Danion1/robot-arm-moveit2/cad_export/antebraco/chapa.step

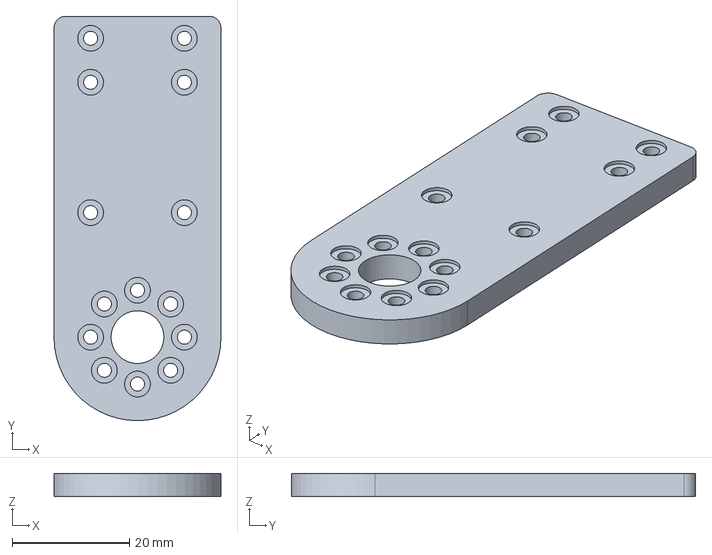
[picture p4: CAD file, 2026-10-29]
cad_export/antebraco/chapa.step
28.5 x 69.0 x 4.00 mm
