Danion1/robot-arm-moveit2/cad_export/base/base.step

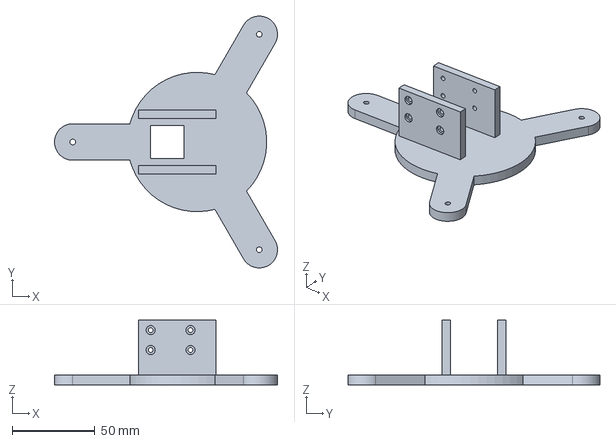
[picture p5: CAD file, 2026-10-29]
cad_export/base/base.step
134.5 x 151.9 x 39.0 mm
