Danion1/robot-arm-moveit2/cad_export/braco/chapa.step

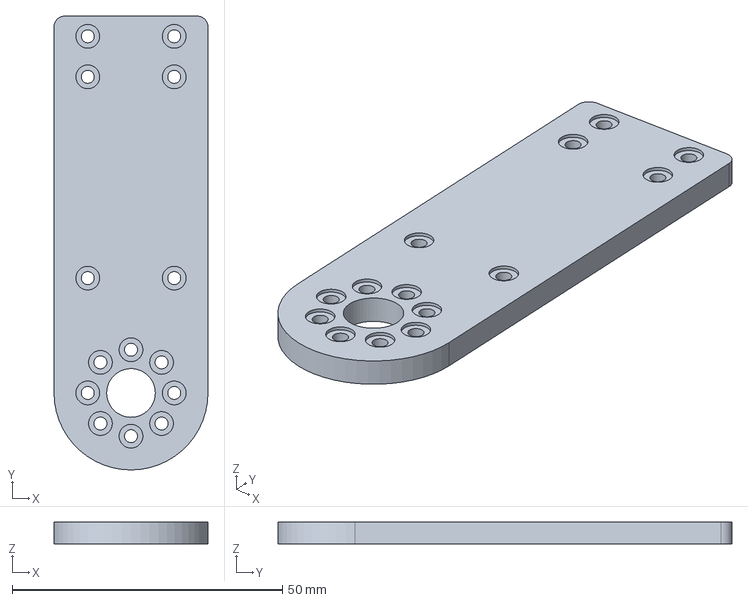
[picture p6: CAD file, 2026-10-29]
cad_export/braco/chapa.step
28.5 x 84.0 x 4.00 mm
