Danion1/robot-arm-moveit2/cad_export/garra/guia_baixo.step

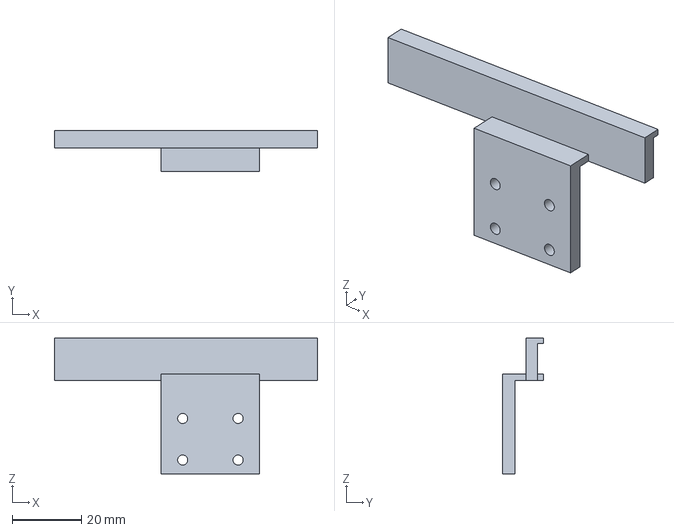
[picture p7: CAD file, 2026-10-29]
cad_export/garra/guia_baixo.step
75.9 x 11.8 x 39.2 mm
