Danion1/robot-arm-moveit2/cad_export/junta/ponte.step

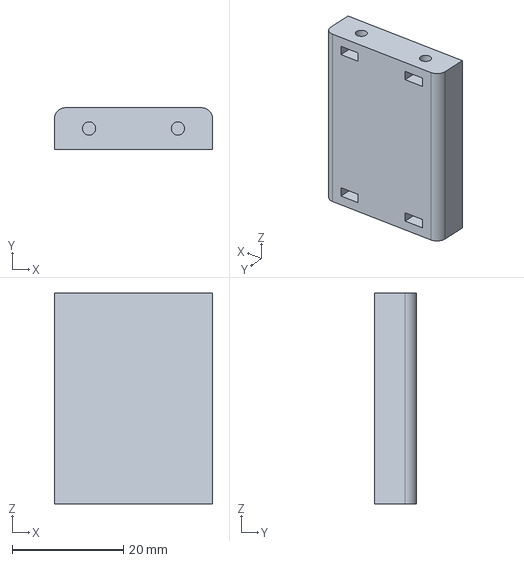
[picture p8: CAD file, 2026-10-29]
cad_export/junta/ponte.step
28.5 x 7.50 x 38.0 mm
