Danion1/robot-arm-moveit2/ros2/braco2_description/meshes/mordente_baixo.stl

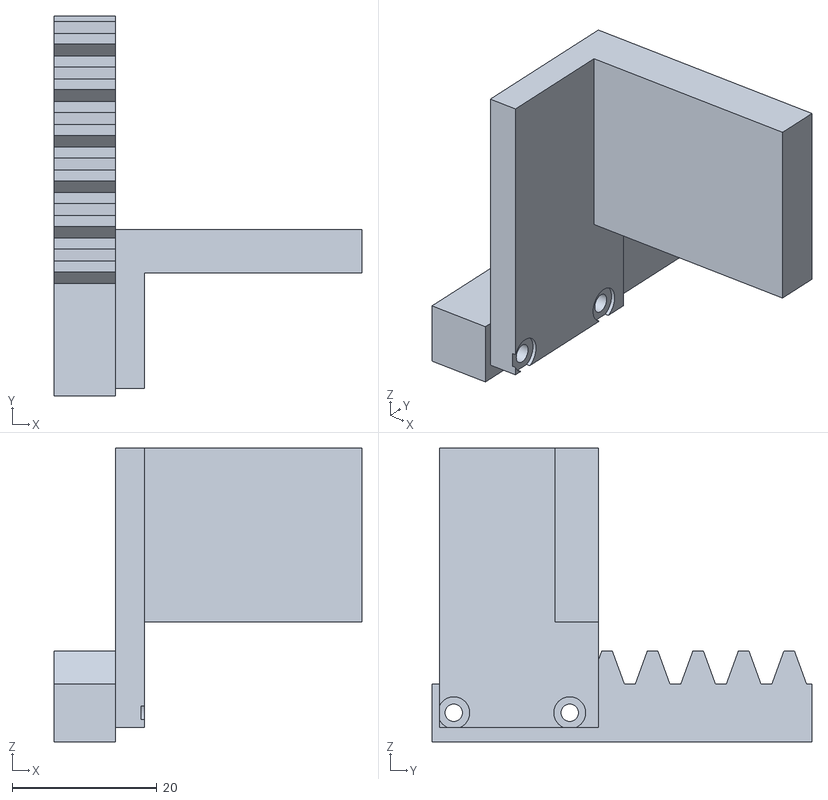
[picture p9: CAD file, 2026-10-29]
ros2/braco2_description/meshes/mordente_baixo.stl
42.5 x 52.4 x 40.5
