Danion1/robot-arm-moveit2/cad_export/antebraco/flange.step

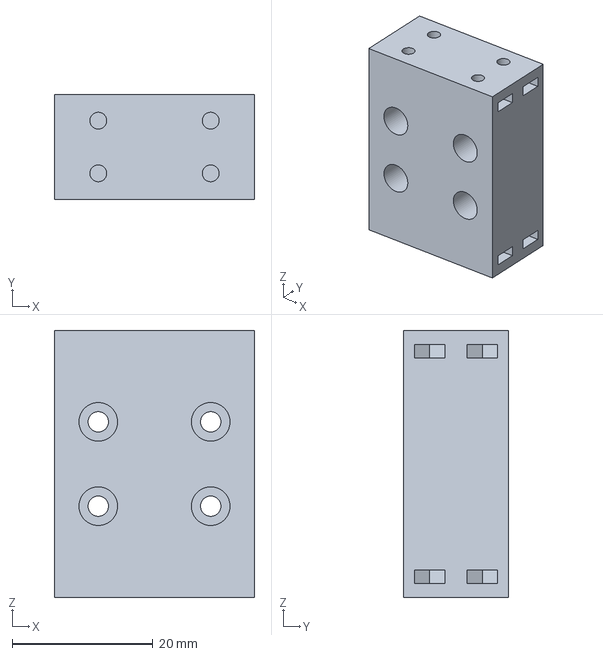
[picture p10: CAD file, 2026-10-29]
cad_export/antebraco/flange.step
28.5 x 15.0 x 38.0 mm
