Danion1/robot-arm-moveit2/cad_export/base/torre.step

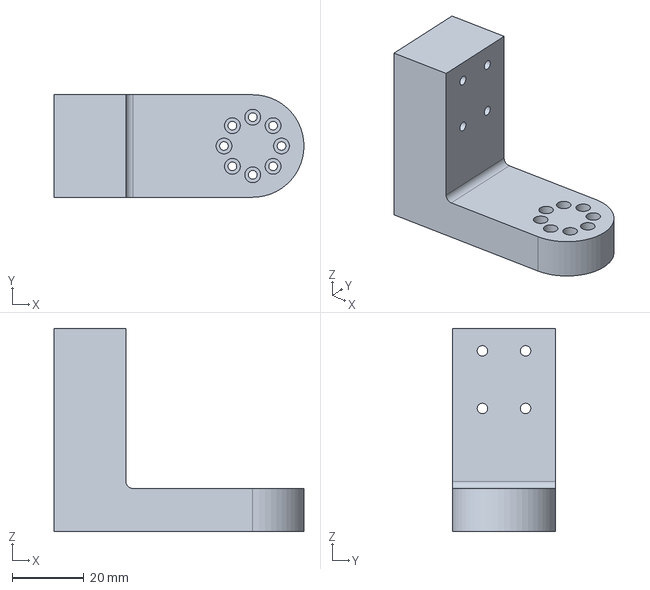
[picture p11: CAD file, 2026-10-29]
cad_export/base/torre.step
69.5 x 28.5 x 56.5 mm
