Danion1/robot-arm-moveit2/cad_export/garra/pinhao.step

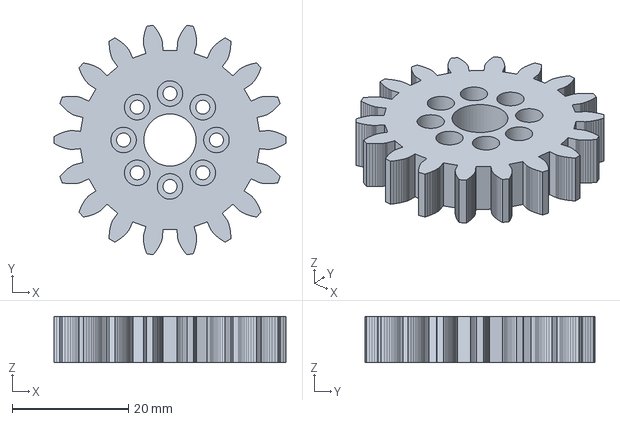
[picture p12: CAD file, 2026-10-29]
cad_export/garra/pinhao.step
40.0 x 39.6 x 8.00 mm
