Danion1/robot-arm-moveit2/cad_export/junta/chapa.step

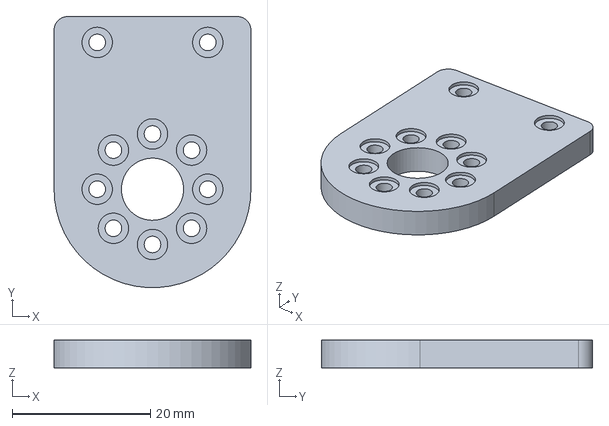
[picture p13: CAD file, 2026-10-29]
cad_export/junta/chapa.step
28.5 x 39.2 x 4.00 mm
