Danion1/robot-arm-moveit2/ros2/braco2_description/meshes/mordente_baixo_colisao.stl

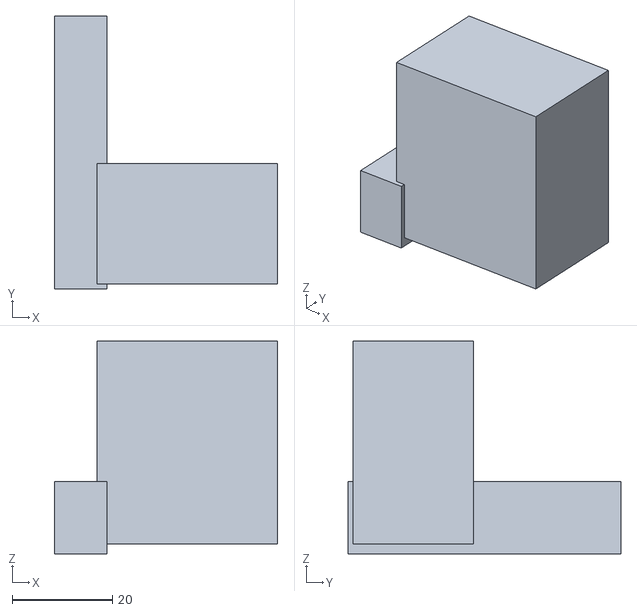
[picture p14: CAD file, 2026-10-29]
ros2/braco2_description/meshes/mordente_baixo_colisao.stl
44.5 x 54.4 x 42.5
