Danion1/robot-arm-moveit2/cad_export/garra/guia_cima.step

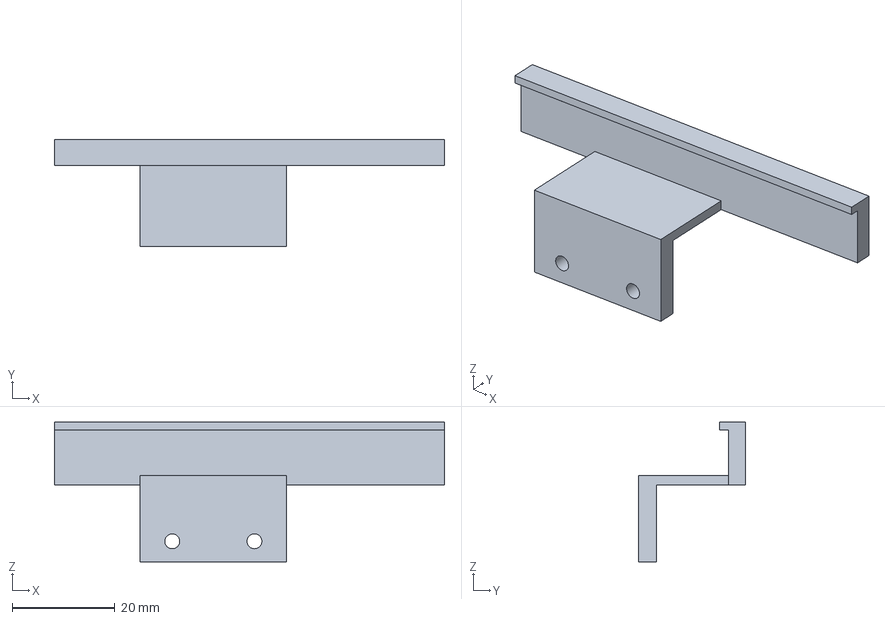
[picture p15: CAD file, 2026-10-29]
cad_export/garra/guia_cima.step
75.9 x 20.8 x 27.2 mm
