Danion1/robot-arm-moveit2/ros2/braco2_description/meshes/link3_colisao.stl

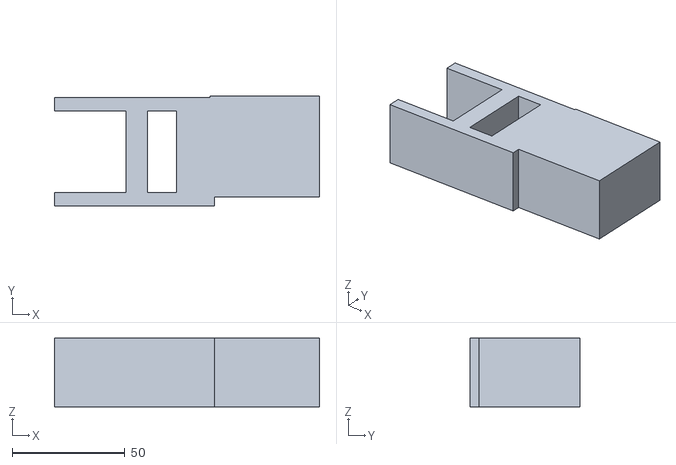
[picture p16: CAD file, 2026-10-29]
ros2/braco2_description/meshes/link3_colisao.stl
117.5 x 48.7 x 30.5
