Danion1/robot-arm-moveit2/cad_export/garra/cremalheira.step

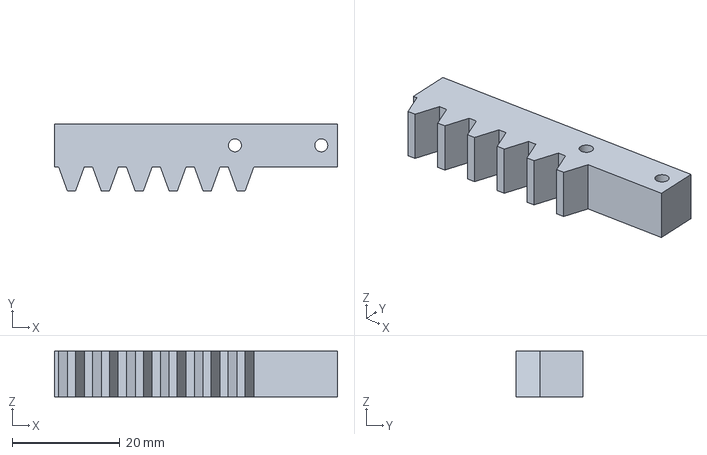
[picture p17: CAD file, 2026-10-29]
cad_export/garra/cremalheira.step
52.4 x 12.5 x 8.50 mm
