Danion1/robot-arm-moveit2/ros2/braco2_description/meshes/link3.stl

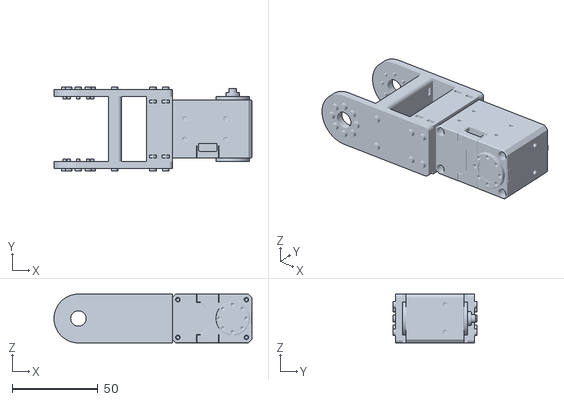
[picture p18: CAD file, 2026-10-29]
ros2/braco2_description/meshes/link3.stl
115.5 x 49.0 x 28.5
