Danion1/robot-arm-moveit2/cad_export/garra/chapa_mao.step

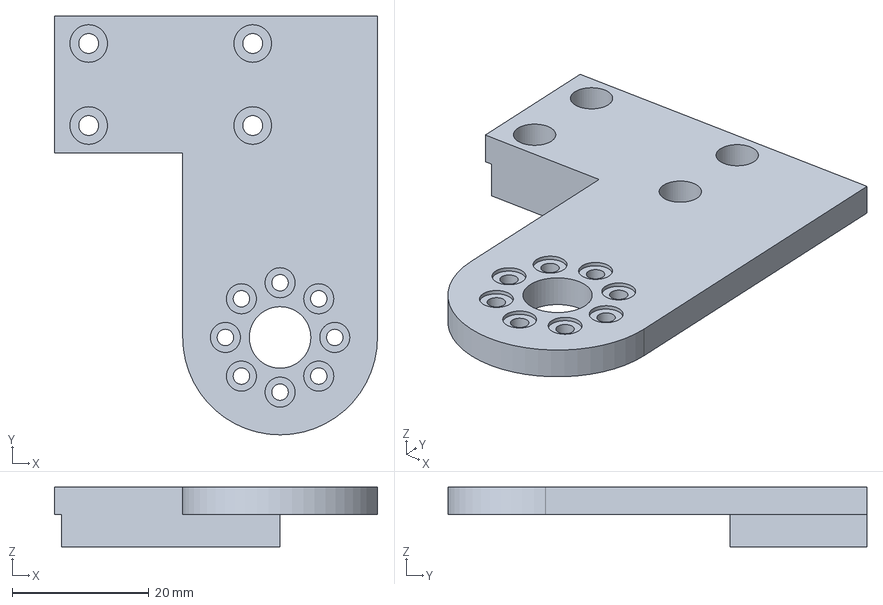
[picture p19: CAD file, 2026-10-29]
cad_export/garra/chapa_mao.step
47.2 x 61.2 x 8.75 mm
