Danion1/robot-arm-moveit2/ros2/braco2_description/meshes/base_link_colisao.stl

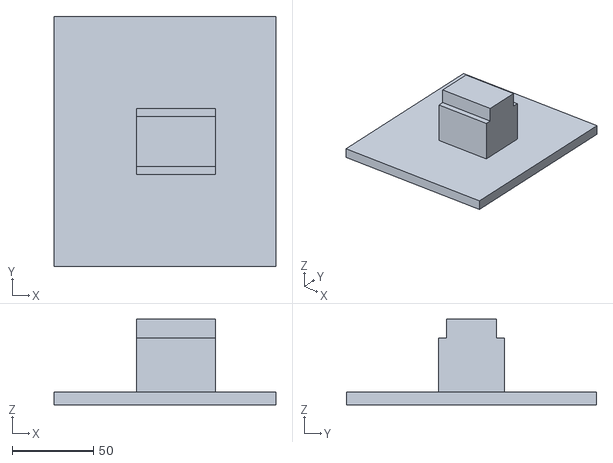
[picture p20: CAD file, 2026-10-29]
ros2/braco2_description/meshes/base_link_colisao.stl
136.5 x 153.9 x 52.7
