Danion1/robot-arm-moveit2/cad_export/garra/mordente.step

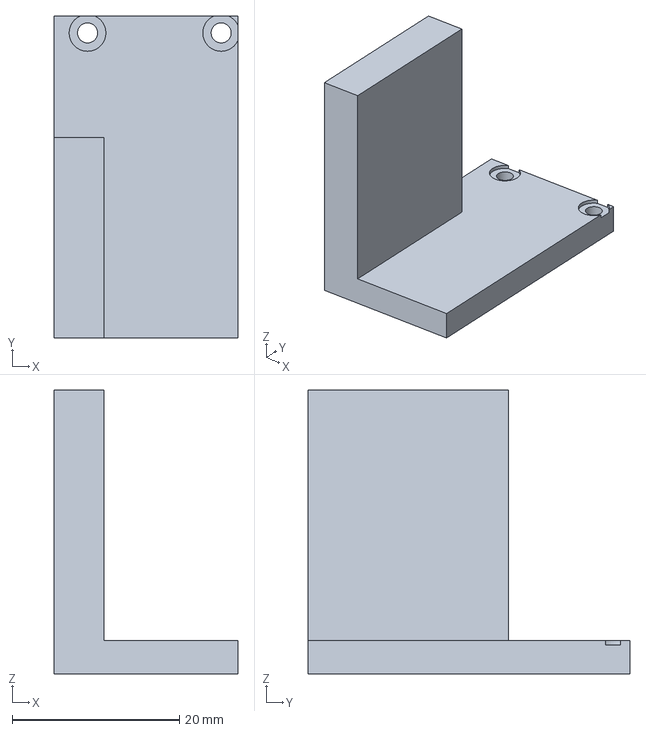
[picture p21: CAD file, 2026-10-29]
cad_export/garra/mordente.step
22.0 x 38.5 x 34.0 mm
