Danion1/robot-arm-moveit2/ros2/braco2_description/meshes/link1_colisao.stl

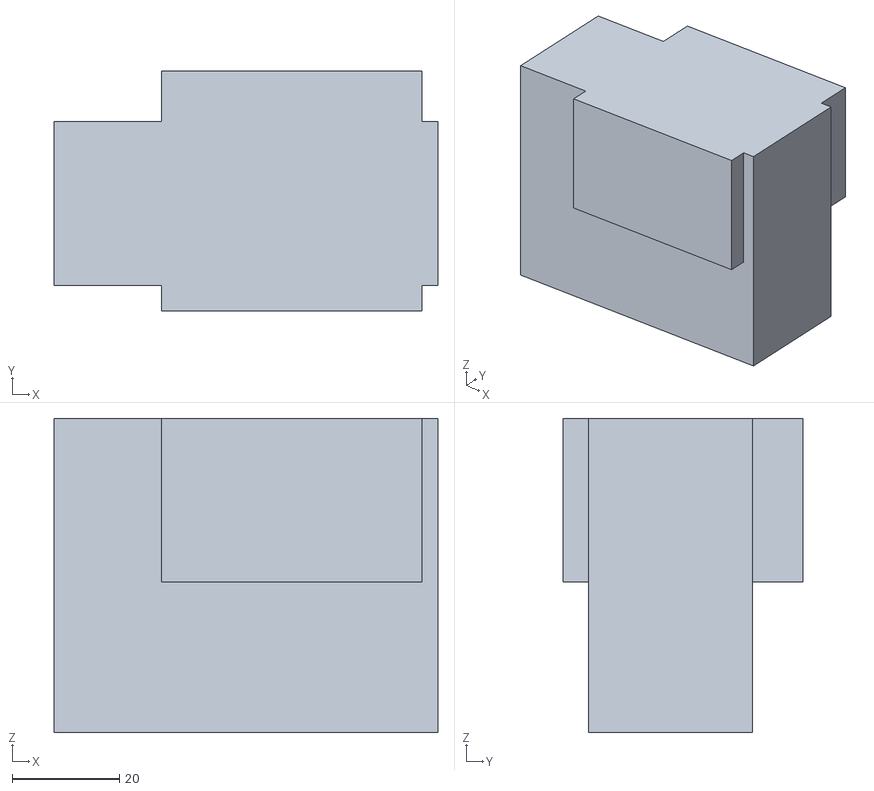
[picture p22: CAD file, 2026-10-29]
ros2/braco2_description/meshes/link1_colisao.stl
71.5 x 44.7 x 58.5
