Danion1/robot-arm-moveit2/ros2/braco2_description/meshes/base_link.stl

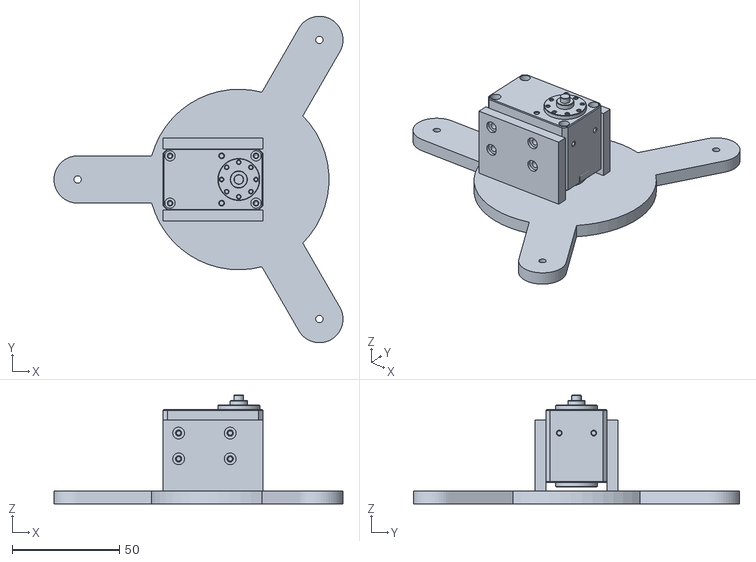
[picture p23: CAD file, 2026-10-29]
ros2/braco2_description/meshes/base_link.stl
134.5 x 151.9 x 50.7
