Danion1/robot-arm-moveit2/ros2/braco2_description/meshes/link4.stl

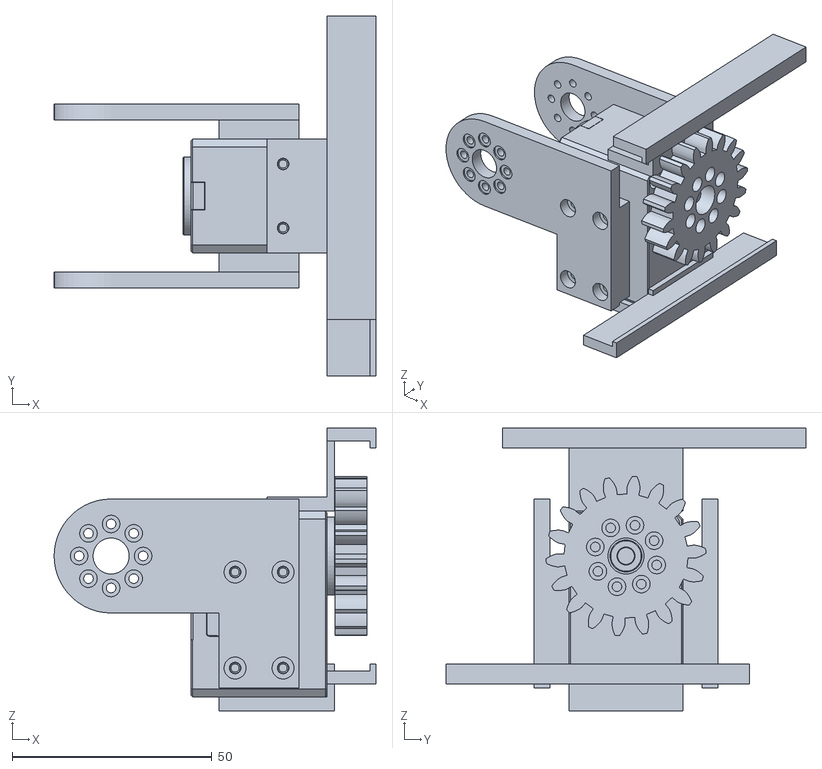
[picture p24: CAD file, 2026-10-29]
ros2/braco2_description/meshes/link4.stl
80.4 x 90.0 x 70.8
