Danion1/robot-arm-moveit2/ros2/braco2_description/meshes/link1.stl

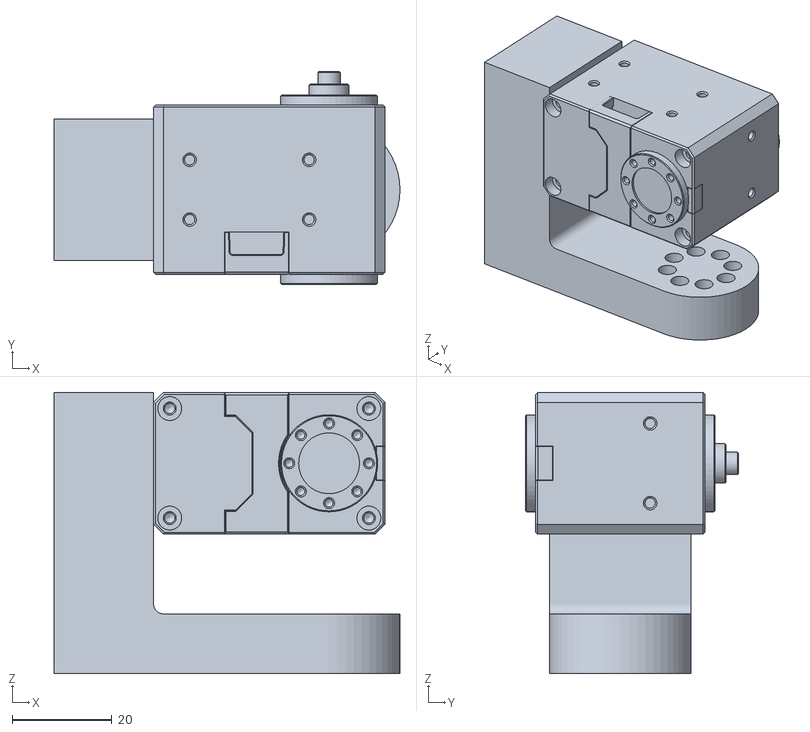
[picture p25: CAD file, 2026-10-29]
ros2/braco2_description/meshes/link1.stl
69.5 x 42.7 x 56.5
