Danion1/robot-arm-moveit2/ros2/braco2_description/meshes/link2.stl

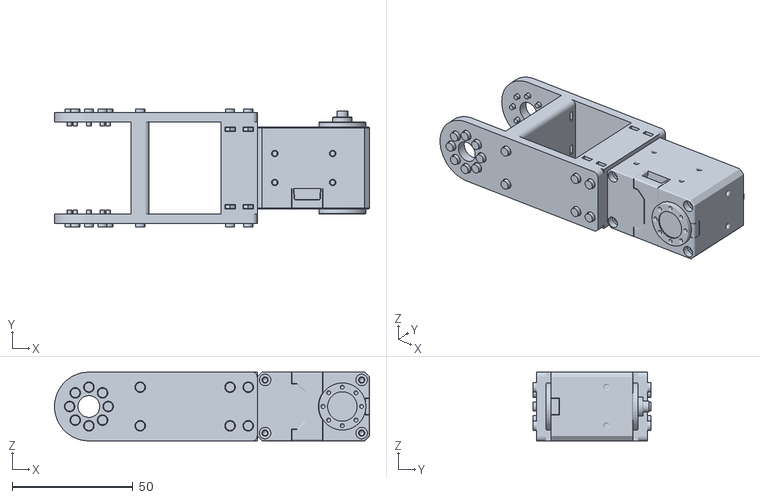
[picture p26: CAD file, 2026-10-29]
ros2/braco2_description/meshes/link2.stl
130.5 x 49.0 x 28.5
