Danion1/robot-arm-moveit2/ros2/braco2_description/meshes/link4_colisao.stl

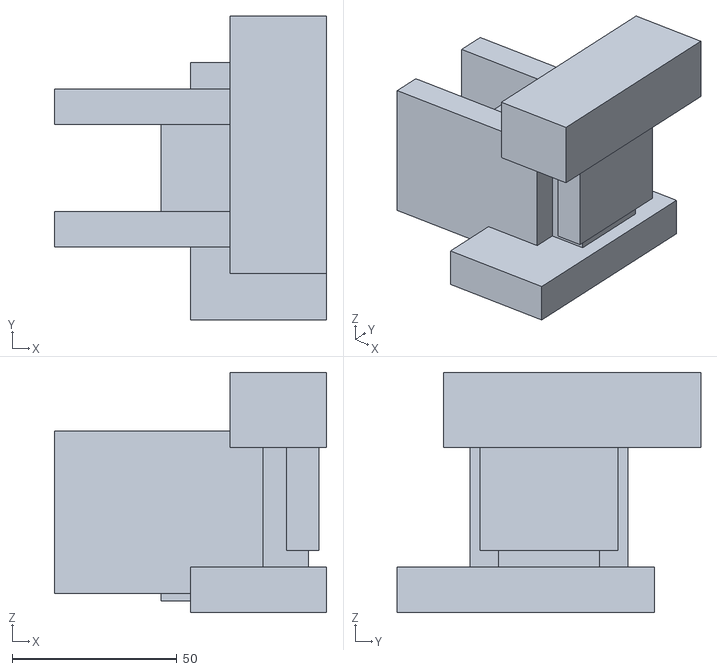
[picture p28: CAD file, 2026-10-29]
ros2/braco2_description/meshes/link4_colisao.stl
82.4 x 92.0 x 72.8
