Danion1/robot-arm-moveit2/(list of files, cad)

Other CAD files:
cad_export/braco/flange.step
ros2/braco2_description/meshes/mordente_cima_colisao.stl
ros2/braco2_description/meshes/mordente_cima.stl
cad_export/antebraco/chapa.stl
cad_export/antebraco/flange.stl
cad_export/base/base.stl
cad_export/base/torre.stl
cad_export/braco/chapa.stl
cad_export/braco/flange.stl
cad_export/garra/chapa_mao.stl
cad_export/garra/cremalheira.stl
cad_export/garra/guia_baixo.stl
cad_export/garra/guia_cima.stl
cad_export/garra/mordente.stl
cad_export/garra/pinhao.stl
cad_export/junta/chapa.stl
cad_export/junta/ponte.stl
