Danion1/robot-arm-moveit2/(commit log)

2026-10-29 Clean copy of the 4-DOF arm project (CAD, ROS 2 packages, results, media)
    [base.step, base.stl, base_link.stl, base_link_colisao.stl, braco.urdf, braco2.ros2_control.xacro, braco2.urdf.xacro, braco_gazebo.urdf.xacro]
2026-10-29 Add engineering decisions, sources and CAD images in docs/
2026-10-29 README (EN + pt-BR): clone instructions, CAD regeneration, docs links, root LICENSE
2026-10-29 README: print and assemble guide (parts, quantities, hardware); how the object position is given; perception in roadmap
