Danion1/robot-arm-moveit2/(notices)

Notices in the files:
README.md:
License: Apache 2.0
